goyen/SmartFarm/README.md

# SmartFarm
Details are in the file Smart-Farm.pdf

Summary
Development environment 
H/W 
  - Windows 10

Circuit design
  - Altium Designer 18
  - Viewmate
  - Proteus 8

3D modeling
  - Inventor( form Auto CAD)

S/W
  - C Language
  - App inventor

F/W
  - Arduino( Atmega328p)
Arduino Project



Demonstration Video:

https://youtu.be/EHqPDaV9Kio

https://youtu.be/m1ZqsnWkN58
